BlinkyStitt/smart-compass-v0/designs/carrier/dust-sealing.md

# USB-C inlet and dust protection

The rear cover closes the four old vents and encloses the USB-C inlet
and regulator. The USB-C socket faces down. Fit its tethered cap when
the cable is unplugged. Use the [60 W assembly guide](wall-power-pd60.md)
to finish the opening, check gasket compression and secure the boards.

## Close the other dust paths

| Path | Seal for the prototype |
| --- | --- |
| Rear cover seam | Fit the silicone face seal in the continuous rear-cover groove. Seal the six rear screws separately. |
| Battery door | Seat the hatch gasket on the rear cover and tighten its four screws evenly. Keep the pull ribbon inside the gasket. |
| Front lens and glow ring | Fit the lens cord in the bezel. Fill the two shell shoulder grooves with clear sealant. |
| Buttons and disconnect | Use the supplied O-rings on the three APEM ICP3FAD2 buttons. Fit the C&K 759D02000 boot to the disconnect. Check the underside and fastener paths. |
| Cable passages, strap mounts and fastener pockets | Inspect each opening for a path into the cavity. Close unused cable passages and keep strap hardware in blind features or outside the seal. |
| Printed surfaces | Inspect for cracks, pinholes and layer gaps. Check that the gasket lands are flat and continuous. Verify the finished print as part of the assembly. |

## Fit the rear cover seal

Fit a 1 mm silicone cord loop with a nominal 197.5 mm centreline diameter
(about 620.5 mm circumference). Use a factory joined loop with a smooth
joint. The groove is 1.4 mm wide and 0.8 mm deep. The revised shell has a
continuous bearing face below its strap slots. The cover and shell meet
at the rim and set the nominal seal compression to 20 percent.
Check for full contact with the print seated. Tighten the six M3 screws
evenly in a cross pattern and seal under their washers. Use removable
fastener seals on the four cell cradle mounts. The disconnect guard is
part of the rear cover.
The seven carrier PCB screws use blind pilots.
[Silicone cord source](https://cormanufacturing.com/o-ring-cord-and-custom-extrusions/),
[Parker face seal guidance](https://www.parker.com/content/dam/Parker-com/Literature/O-Ring-Division-Literature/ORD-5700.pdf)

## Fit the battery hatch

Fit a joined 1 mm silicone cord loop in the hatch groove. The nominal
centreline is a rounded rectangle 123.2 × 53.3 mm with 3.6 mm corner radii.
Its length is about 347 mm. The groove is 1.2 mm wide and 0.8 mm deep.
Keep the cradle and its four mounting screws inside the gasket perimeter.
Tap the four blind pilots M3. Fit four M3 × 14 mm screws with 0.5 mm
washers. Check screw depth and tighten evenly until the flange seats.

Disconnect USB and set the disconnect switch to OFF before cell service.
Remove the four screws and lift the hatch straight off. Turn the keeper
only after you can hold the cell. Reseat the keeper before refitting the
hatch. If the hatch rocks or stands proud, check the cell and ribbon
positions before tightening.

## Fit the lens and glow band

Seat a joined 1 mm silicone cord loop in the bezel groove. The centreline
diameter is 183 mm. Check full contact against the acrylic outside the
opening. Fit the six bezel nuts and screws, then close the exposed nut
loading slots with a removable bead of sealant.

Dry fit the glow ring between its two shell shoulders. Apply a small
continuous bead of clear, electronics-compatible neutral-cure silicone
in each shoulder groove. Keep it off the lit wall and acrylic coatings.
Use the sealant maker's cure conditions and check adhesion on PETG scraps.
[DOWSIL 3145 RTV sealant](https://www.dow.com/en-us/pdp.dowsil-3145-rtv-mil-a-46146-adhesive--sealant.01059548z.html)

## Verify the assembled case

Target **IP6X** for the complete assembled case under IEC 60529. Test the
actual print, seals, fasteners, controls, cell door and USB-C panel seal. Test with
the wall cable installed and with the USB-C port capped. Cycle
the door, controls and cable before repeating the dust check. Open the
case in a clean area and inspect inside the electronics and optical cavity
for dust after the chamber test. [IEC 60529 enclosure protection standard](https://webstore.iec.ch/en/publication/2452)

Measure the cell, charger, boost, PD regulator, LED and case temperatures in the closed
vent-free case while the display runs and charges on the wall. Check both
the powered and battery-only configurations. Set the usable brightness
from the measured thermal limits. The complete enclosure seal and the
vent-free thermal limit remain unverified until the physical tests pass.
