BlinkyStitt/smart-compass-v0/(list of files, cad)

Other CAD files:
designs/stacked/exports/FitBatteryContactPFront.3mf
hardware/enclosure/exports/smart-compass.step
hardware/enclosure/sources/sparkle-motion-mechanical/6100.step
designs/stacked/exports/SideDiffuser.3mf
hardware/enclosure/exports/BarrelFrame.3mf
designs/stacked/exports/BatteryKeeper.3mf
hardware/enclosure/exports/FitRear.3mf
designs/stacked/exports/stacked-fibonacci.step
hardware/enclosure/exports/OpticalDeck.3mf
designs/stacked/exports/BlackPillRetainer2.3mf
hardware/enclosure/exports/FitSuspensionRear.3mf
designs/stacked/exports/HarnessSpliceCarrierGND.3mf
hardware/enclosure/exports/FitOptics.3mf
designs/stacked/exports/FitInnerDiffuser-silver.3mf
hardware/enclosure/exports/InnerRing-silver.3mf
designs/stacked/exports/BlackPillRetainer3.3mf
hardware/enclosure/exports/RearPlate.3mf
designs/stacked/exports/FitInnerDiffuser.3mf
hardware/enclosure/exports/FitBarrel.3mf
designs/stacked/exports/FitBatteryContactNFront.3mf
hardware/enclosure/exports/EdgeDiffuser-silver.3mf
designs/stacked/exports/HarnessSpliceCarrierLED_DISTRIBUTION.3mf
hardware/enclosure/exports/FitFibonacciBaffle.3mf
designs/stacked/exports/FitBatteryContactPBack.3mf
hardware/enclosure/exports/FitRingOutside-silver.3mf
designs/stacked/exports/HarnessSpliceCarrierAUX_3V3.3mf
hardware/enclosure/exports/ServiceCover.3mf
designs/stacked/exports/HarnessSpliceCarrierSPI_CLOCK.3mf
hardware/enclosure/exports/VentGuard3.3mf
designs/stacked/exports/StartBackplate.3mf
hardware/enclosure/exports/HaloRing-silver.3mf
designs/stacked/exports/BatteryCradle.3mf
hardware/enclosure/exports/FitRingHalo.3mf
designs/stacked/exports/LatchCarrier.3mf
hardware/enclosure/exports/FitDeck.3mf
designs/stacked/exports/ActionBezel.3mf
hardware/enclosure/exports/NecklaceLink1.3mf
designs/stacked/exports/ActionBackplate.3mf
hardware/enclosure/exports/FitRingInner-silver.3mf
designs/stacked/exports/InnerDiffuser-silver.3mf
hardware/enclosure/exports/FibonacciBaffle.3mf
designs/stacked/exports/StartBezel.3mf
hardware/enclosure/exports/FitSuspensionBracketLeft.3mf
designs/stacked/exports/FitSideDiffuser-silver.3mf
hardware/enclosure/exports/InnerRing.3mf
designs/stacked/exports/RearCover.3mf
hardware/enclosure/exports/NecklaceLink0.3mf
designs/stacked/exports/FitSuspensionLeft.3mf
hardware/enclosure/exports/FitSuspensionBracket.3mf
designs/stacked/exports/SwitchGuard.3mf
hardware/enclosure/exports/VentGuard2.3mf
designs/stacked/exports/HarnessSpliceCarrierB.3mf
hardware/enclosure/exports/FitRingOutside.3mf
designs/stacked/exports/FitHarnessSpliceCarrierSENSE.3mf
hardware/enclosure/exports/EdgeDiffuser.3mf
designs/stacked/exports/FitBatteryDoor.3mf
hardware/enclosure/exports/CircleRimFoot0.3mf
designs/stacked/exports/RadioRetainer0.3mf
hardware/enclosure/exports/CircleRimFoot1.3mf
designs/stacked/exports/InnerDiffuser.3mf
hardware/enclosure/exports/HaloRing.3mf
designs/stacked/exports/ModeBezel.3mf
hardware/enclosure/exports/FitSuspensionFrame.3mf
designs/stacked/exports/EGLStencil.3mf
hardware/enclosure/exports/CircleRimFoot2.3mf
designs/stacked/exports/LatchClamp0.3mf
hardware/enclosure/exports/FitService.3mf
designs/stacked/exports/ElectronicsShell.3mf
hardware/enclosure/exports/FitRingHalo-silver.3mf
designs/stacked/exports/FitHarnessSpliceCarrierGND.3mf
hardware/enclosure/exports/VentGuard1.3mf
designs/stacked/exports/BoardEdgeClip0.3mf
hardware/enclosure/exports/FitController.3mf
designs/stacked/exports/CapacitorCover.3mf
hardware/enclosure/exports/VentGuard0.3mf
designs/stacked/exports/HarnessSpliceCarrierSPI_MISO.3mf
hardware/enclosure/exports/FitRingInner.3mf
designs/stacked/exports/HarnessSpliceCarrierFIB_5V.3mf
hardware/enclosure/exports/OpticalDeckQ2.stl
designs/stacked/exports/BlackPillCarrier.3mf
hardware/enclosure/exports/OpticalDeckQ4.stl
designs/stacked/exports/FitStartBezel.3mf
hardware/enclosure/exports/BarrelFrameQ3.stl
designs/stacked/exports/RadioCarrier.3mf
hardware/enclosure/exports/RearPlateQ3.stl
designs/stacked/exports/SideDiffuser-silver.3mf
hardware/enclosure/exports/SeamStraps-03.stl
designs/stacked/exports/BatteryContactNFront.3mf
hardware/enclosure/exports/CircleBezel.stl
designs/stacked/exports/RadioRetainer2.3mf
hardware/enclosure/exports/OpticalDeckQ1.stl
designs/stacked/exports/ModeBackplate.3mf
hardware/enclosure/exports/RearPlateQ1.stl
designs/stacked/exports/FitBatteryCradle.3mf
hardware/enclosure/exports/CellBaffle.stl
designs/stacked/exports/HarnessSpliceCarrierSPI_MOSI.3mf
hardware/enclosure/exports/SeamStraps-12.stl
designs/stacked/exports/HarnessSpliceCarrierSENSE.3mf
hardware/enclosure/exports/SeamStraps-04.stl
designs/stacked/exports/LatchClamp2.3mf
hardware/enclosure/exports/RearPlateQ2.stl
designs/stacked/exports/FitSideDiffuser.3mf
hardware/enclosure/exports/OpticalDeckQ3.stl
designs/stacked/exports/HarnessSpliceCarrierBOOST_OUT.3mf
hardware/enclosure/exports/SeamStraps-11.stl
designs/stacked/exports/BoardEdgeClip2.3mf
hardware/enclosure/exports/BarrelFrameQ1.stl
designs/stacked/exports/FitLatchCarrier.3mf
hardware/enclosure/exports/SeamStraps-08.stl
designs/stacked/exports/BatteryDoor.3mf
hardware/enclosure/exports/SeamStraps-10.stl
designs/stacked/exports/BatteryContactPBack.3mf
hardware/enclosure/exports/RearPlateQ4.stl
designs/stacked/exports/BoardEdgeClip1.3mf
hardware/enclosure/exports/BarrelFrameQ2.stl
designs/stacked/exports/LatchClamp1.3mf
hardware/enclosure/exports/SeamStraps-02.stl
designs/stacked/exports/BlackPillRetainer1.3mf
hardware/enclosure/exports/SeamStraps-05.stl
designs/stacked/exports/FitSuspensionRight.3mf
hardware/enclosure/exports/BarrelFrameQ4.stl
designs/stacked/exports/BlackPillRetainer0.3mf
hardware/enclosure/exports/SeamStraps-06.stl
designs/stacked/exports/BatteryContactNBack.3mf
hardware/enclosure/exports/SeamStraps-09.stl
designs/stacked/exports/BatteryContactPSpacer1.3mf
hardware/enclosure/exports/BoardMounts-13.stl
designs/stacked/exports/BlackPillDrainBridge.3mf
hardware/enclosure/exports/BoardMounts-07.stl
designs/stacked/exports/StartCompression0.3mf
hardware/enclosure/exports/SeamStraps-07.stl
designs/stacked/exports/BatteryContactNSpacer1.3mf
hardware/enclosure/exports/HatchStandoff1.stl
designs/stacked/exports/BoostInputRelief.3mf
hardware/enclosure/exports/BoardMounts-06.stl
designs/stacked/exports/FitBoardEdgeSeat.3mf
hardware/enclosure/exports/BoardMounts-12.stl
designs/stacked/exports/ModeCompression1.3mf
hardware/enclosure/exports/BoardMounts-14.stl
designs/stacked/exports/ModeCompression0.3mf
hardware/enclosure/exports/BoardMounts-09.stl
designs/stacked/exports/BatteryHingeSpacer0.3mf
hardware/enclosure/exports/BoardMounts-10.stl
designs/stacked/exports/RadioRetainer1.3mf
hardware/enclosure/exports/BoardMounts-03.stl
designs/stacked/exports/FitBatteryContactNBack.3mf
hardware/enclosure/exports/SeamStraps-01.stl
designs/stacked/exports/FitBoardEdgeClip0.3mf
hardware/enclosure/exports/BoardMounts-05.stl
designs/stacked/exports/FitBatteryKeeper.3mf
designs/stacked/exports/ActionBackplate.stl
designs/stacked/exports/ActionBezel.stl
designs/stacked/exports/ActionCompression0.3mf
designs/stacked/exports/ActionCompression1.3mf
designs/stacked/exports/ActionCompression1.stl
designs/stacked/exports/BatteryContactNSpacer0.3mf
designs/stacked/exports/BatteryContactNSpacer0.stl
designs/stacked/exports/BatteryContactNSpacer1.stl
designs/stacked/exports/BatteryContactPBack.stl
designs/stacked/exports/BatteryContactPSpacer0.3mf
designs/stacked/exports/BatteryContactPSpacer0.stl
designs/stacked/exports/BatteryDoor.stl
designs/stacked/exports/BatteryHingeSpacer1.3mf
designs/stacked/exports/BatteryHingeSpacer1.stl
designs/stacked/exports/BlackPillCarrier.stl
designs/stacked/exports/BlackPillDrainBridge.stl
designs/stacked/exports/BlackPillRetainer1.stl
designs/stacked/exports/BlackPillRetainer2.stl
designs/stacked/exports/BlackPillSenseBridge.3mf
designs/stacked/exports/BranchFuseCarrier.3mf
designs/stacked/exports/BranchFuseCarrier.stl
designs/stacked/exports/CapacitorCover.stl
designs/stacked/exports/EGLStencil.stl
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
