BlinkyStitt/smart-compass-v0/designs/carrier/assembly.md

# Rev A carrier assembly

Use the [routed KiCad board](carrier-a.kicad_pcb) with the 200 mm narrow
enclosure. The board is 1.2 mm thick with four 35 µm copper layers. Keep the
seven rear-cover mounts. Tap their blind 1.6 mm pilots M2 with a depth
stop. Fit seven M2 × 4 mm screws with insulating washers. Check that the
screws hold without bottoming out. The five stock boards plug into the
low-profile sockets from the fit model. Secure the boards with the common
retainer. Pull a connector by its housing and support the carrier near it.

Have the PCB assembler install the small surface-mount parts. Fit the socket
strips, harness headers and axial fuses after reflow. Use a jig to keep the
matching male pins straight when soldering them to the modules. The PowerBoost
uses its stock terminal-block and LBO header holes. Leave R20 and the factory
red LED in place. Use the stock Sparkle Motion barrel jack and screw clamps.
The LED board inputs, switch and cell contacts still need bench wiring. Make
these as subassemblies so final assembly is screw and plug work.

## Fit the carrier retainer

Fit the seven boards and their plugs on the bench. Fit soft insulating
silicone pads to the retainer toes. Use 1 mm stock for the 0.8 mm installed
gap. The five round toes bear around stock mounting holes. The other
three toes bear on the outer PCB edges of the radio, BlackPill and latch.
Keep pads on those bearing faces and clear of headers and components.
Check that each pad touches its PCB when all five feet sit on their stops.
Check for PCB flex before tightening.

Ream the five frame bores to 2.8 mm if needed. Tap the rear cover's 2.05 mm
blind pilots M2.5 × 0.45. Use five M2.5 × 25 mm button-head screws with
heads no wider than 4.5 mm and no taller than 1.6 mm. Tighten by hand until
the frame feet seat. Move the local service folds clear before lifting
the retainer during service. [Example M2.5 × 25 mm hardware](https://www.aspenfasteners.com/m2-5-0-45-x-25mm-iso-7380-1-metric-button-head-hex-socket-cap-screws-class-10-9-steel-plain/)

## Install the panel controls

Use three black, flat [APEM ICP3FAD2](https://www.apem.com/en-us/panel-switches/pushbutton-switches/ic/icp3fad2)
normally open buttons with factory flying leads. Fit the supplied O-ring
under each flange. The 2 mm panel lands have a 13.60 mm opening with flats
12.90 mm apart. Hold the button against the flats while tightening the
supplied nut. Check the seal seats fully and the button returns freely.
APEM specifies a maximum nut torque of 1.5 N·m. Use only the torque needed
to seat the seal against the printed land.

Use the factory 20 AWG leads to make a bench harness. Join them to the
26 AWG PH leads using insulated splices rated for the two wire sizes.
Leave 20 mm of service slack. Fit the C&K 759D02000 sealing boot on the
7201SYZQE disconnect in place of its external nut. Check that the boot moves freely
in both positions. Check both switch poles with a continuity meter. [C&K switch and boot drawing](https://www.ckswitches.com/media/1394/7000toggle.pdf)

## Fit the battery contacts

Print the cradle and the two `BatteryContact*Front` clamps. Clear the
support material from the wire passages, contact seats, and screw holes.
Finish the fixed seats and clamp bores to 2.75 ± 0.05 mm. Feed the bare
wire through its conduit before soldering the contact outside the print.
Let it cool. Pull the wire through until the contact flange seats against
the integral back face.
Fit the front clamp over the plunger. Keep the original M2 fasteners
and the 0.25 mm insulating washers at the compression bosses. Fit the negative clamp with its insulating stop at the
negative end. Support the leads during tightening.

Check that each contact is captive, its plunger moves freely, and the
positive contact stays insulated from the mounting hardware.
Use the keyed contact dimensions below to set the Rev A clamps.
[Spring-contact reference drawing](../../hardware/enclosure/battery-access.md)

## Plugs

Pin order is the PCB pad order starting at pin 1. Read pad numbers in KiCad or
use the square pad for the JST headers. Label both ends of each lead before
installation. Use the [carrier parts and pad map](routed-components.json) for
part locations. Use the [stock module source records](../../hardware/enclosure/electrical-design.md)
for the module pins.

| Carrier | Header | Connections in pad order |
| --- | --- | --- |
| J1 | JST B4P-VH | Charger BAT, ground, charger SYS, charger TS sense |
| J2 | JST B3P-VH | Fused cell positive through S1 pole A, cell negative, holder thermistor |
| J3 | JST B5P-VH | Pololu VIN, VOUT, GND, A, OFF |
| J4 | JST B6P-VH | PowerBoost X2.2, X2.1, X1.2, X1.1, JP1.4 LBO, empty |
| J5 | JST B2B-XH-A | S1 pole B RUN contact, S1 pole B common |
| J6 | JST B2P-VH | Sparkle Motion 2.1 mm barrel plug center, sleeve |
| J7 | JST B5B-XH-A | Sparkle JP1.9, JP1.7, JP1.8, JP1.5, JP1.2 |
| J8 | JST B3B-XH-A | Fibonacci 5V, GND, DIN |
| J9 | JST B3B-XH-A | Inner ring 5V, GND, DIN |
| J10 | JST B3B-XH-A | Side ring A 5V, GND, DIN |
| J11 | JST B3B-XH-A | Side ring B 5V, GND, DIN |
| J12 | JST B6B-PH-K | Start pair, Mode pair, Action pair |

J8 through J11 have the same power, ground and data order. Labels identify the
four outputs. Keep the 1000 µF bulk capacitor at the Fibonacci end of J8. R8
drains this branch while J8 is seated. Keep all other USB ports for service and
isolate them from live wall or battery power.

Use precrimped 18 AWG for the cell power and charger SYS paths, 22 AWG for the
barrel feed and LED power, and 26 AWG for controls and LED data. Match the
terminal to each wire gauge. Where the VH contact range ends at 22 AWG, join
the short 22 AWG pigtail to a thinner control or thermistor lead in the
subassembly. Use one conductor per clamp on Sparkle Motion.

Keep the contact-adjacent 4 A fuse in the positive cell lead. Connect the fused
positive lead to S1 terminal 1 and J2.1 to terminal 2. Connect J5.1 to terminal
4 and J5.2 to terminal 5. Insulate unused S1 terminals 3 and 6. Check the
delivered switch with a continuity meter in both positions. The ground return
and thermistor stay in the holder harness. The battery positive contact is
isolated in OFF. Unplug wall USB before opening the case or changing the cell.

## Make the first harness against the actual case

- Leave 25 mm of slack at the cell, charger, switch, and LED clamp harness.
- Leave 20 mm at the barrel, boost, latch, and button harnesses.
- Leave 40 mm in each of the four front LED cables so the cover can open
  about 30 mm and leave 10 mm for access to the plugs.
- Route the power and return leads together. Form gentle U-bends in the
  available spaces. Use a removable soft tie to hold each fold. Keep bends out
  of the battery door path, cover rim, and fastener seats.

Measure the bent route between the actual lead exits and add the slack and
termination allowance before cutting. The model checks room for the mated
housings and the existing fold reservations. The charger harness needs its
own fitted fold and lead-exit check. Test finger access and the completed wires on the
first assembly. Check module retention and antenna behavior with the PCB in
place. Weigh the assembled prototype to capture the cost of the extra plugs
and charger.

## Check the keyed positive contact

Use both revised front clamps from the Rev A print package. The circular
guard on `BatteryContactPFront` faces the cell. Clear its opening of print
material and keep the insulating bearing face flat.
With both power sources disconnected, check that the unloaded positive pin is
0.42–0.56 mm behind that face. Set the unloaded tip gap to 74.12–74.20 mm and the
negative stop compression to 1.82–1.90 mm.

The keyed holder accepts a protected 21700 cell 74.3–75.3 mm long and
21.5–22.1 mm in diameter. Check the actual XTAR cell. Its positive button
must be 5–9 mm in diameter, 1.0–1.6 mm high and within 1 mm of the opening axis
when seated. The negative end must have no more than 0.27 mm of central
protrusion toward the pin when its bearing surface is against the clamp.
Use electrically isolated dummy gauges to check contact in the correct
orientation and no contact during reversed insertion or with the keeper closed.
Confirm that pushing against the negative stop releases the button
before withdrawing the dummy. A cell outside these limits needs a fit
review. [XTAR product sheet](https://www.xtar.cc/download/21700-6000mah-data-sheet?wpdmdl=10996)

## Verify the carrier

Open the board in KiCad 10. Run the DRC with the ground plane refilled.

```sh
kicad-cli pcb drc --refill-zones --exit-code-violations \
  designs/carrier/carrier-a.kicad_pcb
```

The board contains the editable copper. `pcb_placement.py` still makes the
stock socket and outline gauge. `route_board.py` adds the power and harness
connections and exports a Specctra placement from that gauge. Use the stock
footprint libraries from KiCad 10. Review routing after any changes to the
placement or connector map.

For the mechanical check, set `COMPASS_CARRIER_SOURCE` to the absolute
path to `designs/carrier` and set `COMPASS_CARRIER_OUTPUT` to a writable
directory. Run `RunRoutedFit.FCMacro` in FreeCAD. It records the mated plugs,
the internal USB-C hardware, charger envelope, hatch and retainer fit and cell service in
`routed-fit.json`. It exports `usb-c-rear-cover.step` and the nine revised
print solids as STLs. Make the complete print package with the
[Rev A build instructions](README.md#make-the-rev-a-print-package).

Use the [wall power design](wall-power-pd60.md) and [dust sealing plan](dust-sealing.md)
before connecting the charger or a cell. First power up the carrier through
J1 SYS and GND on a current-limited 3.6 V bench supply with the battery and
charger disconnected. Check SYS at the latch plug and check for shorts. Install the latch and boost next.
Measure the 5 V rail before installing the other modules and LED loads.
