BlinkyStitt/smart-compass-v0/hardware/enclosure/service-guide.html

# Smart Compass: $material_label print service handoff

Package $package_id · All dimensions are millimetres.

Print samples first. Hold the full order.

Quote both stages. Print $samples disposable samples first. Print the $products full assembly parts only after the customer confirms sample acceptance and releases that stage.

CAD and slicing checks passed. Physical print, fit, strength and optical acceptance remain pending.

## 1. Confirm that you can make this job

- Use a printer with at least a 300 × 300 mm bed. Keep every complete part, brim and skirt inside the actual usable bed. Keep all circles whole. Keep the supplied scale and bed orientation.
- Use opaque black PETG for the frame, deck, rear, brackets, original EGL centre stencil, spacers, guards and cover. Use $material_name for the three light rings and their arc samples. Identify your proposed opaque black PETG brand and grade before printing. Check that the production-wall samples block visible LED light at the permitted power limit. Reject light transmission through the black parts. Keep this filament option separate from the other material version.
- Use a 0.4 mm nozzle. $nozzle_instructions
- Use a $brim mm brim, with $brim_gap mm brim separation, and no supports. Keep elephant-foot compensation at $foot mm.
- Print the samples on the production machine with the production filament and settings. Agree to inspect dimensions and functional fits with the actual mating hardware.

$evidence Both versions use the same strong outside wall. Each material needs its own sample acceptance.

## 2. Which files should you use?

Folder / file | Purpose
01-SAMPLES-PRINT-FIRST | Start here. One of each sample. Both bracket arrangements are included.
02-FULL-PARTS-HOLD | One complete $products-part set. Hold until the customer releases it.
03-STL-ALTERNATIVES | The same parts as plain STL geometry. Use these only if your slicer cannot use the 3MF files. Apply the table settings and import in millimetres. These are not additional pieces to print.
04-REFERENCE-DO-NOT-PRINT | Assembly views, a section drawing and the complete assembly STEP. Use them to understand the fit. The STEP includes nonprinted items and is not one print job.
ORDER.csv | The two-stage quantity, material and settings list. Each listed 3MF contains one part.
CHECKSUMS.sha256 | File checksums for shipment integrity.

3MF files are slicer projects, not printer programs. They contain geometry, orientation and reference print settings. They deliberately omit heater setpoints and machine start/end programs. Select your actual machine and filament presets, then retain the specified geometry and process settings. Check the resulting paths before printing. Do not run G-code with zero heater setpoints.

## 3. Sample order — print these first

One of each file below. These samples are disposable and do not enter the final assembly.

File | Use | Qty | Material | Layer / walls | Infill | Path / first layer | Top / bottom layers

$sample_rows

## 4. Full order — hold for sample acceptance

Print the listed quantities below for one complete $products-part printed set. The similarly named spacers and guards are distinct positioned parts; keep their file identities.

File | Part | Qty | Material | Layer / walls | Infill | Path / first layer | Top / bottom layers

$product_rows

### Orientation and path checks

- Keep the optical deck floor down, barrel deck-joint face down, rear skin down, vent guards roof down and necklace brackets flat. Preserve the supplied orientation for the other parts and all fit samples. The projects are centred on the 300 mm reference bed. Centre each part on your actual usable bed without changing its scale; check the whole brim and skirt too.
- Print each light ring upright on its circular bottom edge. Keep the cavity ring walls at $cavity_wall mm and the outside wall at $outside_wall mm. Their 0% infill setting uses continuous perimeter paths to fill the walls.
- Inspect $cavity_paths nominal $cavity_path mm paths in each cavity ring and $outside_paths nominal $outside_path mm paths in the outside ring. The outside first-layer paths are nominally $outside_first_path mm. Check every layer for continuous complete walls, with no missing path, gap fill or internal lattice.
- Print the original EGL centre stencil flat, 2 mm thick, with the supplied 0.1 mm layers, 0.4 mm paths and 100% rectilinear infill. Inspect all thin walls. Fit the complete stencil sample on the actual board, with its three separate spacers and the black LED acrylic front. Keep the source open edge cells.
- The optical deck uses $deck_layer mm layers with $deck_top solid top layers and $deck_bottom solid bottom layers. The first layer stays at $first_layer mm. Retain the collar stops, sheet lands and existing solid skins.

## 5. Sample acceptance — agree with the customer

The customer must supply the actual boards, strips, finished acrylic and fasteners for functional checks. If you cannot do these checks, return the labelled samples for customer testing. Report the machine, filament product/lot, nozzle, settings, measured dimensions and any defects.

- Use actual M3 and M2 screws, plain nuts and washers. Check free screw passage, complete nut insertion and thread engagement, captive-nut pockets, controller mounting and screwdriver access. Keep the rear skin closed.
- Test both bracket arrangements and mating frame/rear samples. Check that the rear can be removed independently.
- Test the front clamp with the actual finished acrylic, 9 mm OD metal washers, and 9 mm OD × 6.4 mm ID soft washers cut from 0.020 inch Stockwell SG-30 GP silicone. Target 60% of measured free washer thickness. The metal washer must bear on the collar while the soft washer retains the sheet. Record the usable tightening limit.
- Test all three ring curvatures and seats. Retain each ring at maximum permitted lift. Require 0.2–0.8 mm measured clearance below the front sheet and at least 0.5 mm actual LED clearance. Keep the $mirror_separation mm mirror separation and at least 18 mm radial cavity width.
- Inspect the $outside_wall mm outside arc for voids, cracks and layer separation. Repeat installation and removal. Whole-ring handling still requires a full-size test.
- Fit the three opaque light shields, actual strips and front-sheet sample. Reject exposed LED edges or light leaking above the rings. Check shield adhesion, sag, sheet clearance and removal with the ring. The shields use 0.06 mm tesa 7160 black PET tape; they are separate cut parts.
- $optical_acceptance Use the customer's permitted LED power limit. The rendered appearance is an unmeasured illustration.

If a sample fails, stop the full order, correct the cause and repeat the affected test. Do not substitute material or relax an acceptance requirement without a new customer decision.

## 6. Full-size inspection and packing

- Inspect cooled parts after brim removal. Reject cracks, incomplete walls, lifted edges, permanent distortion and layer separation. Do not use bolts to flatten a part.
- Dry-assemble the complete set on a flat reference. Require joint gaps no greater than 0.3 mm, free screw passage, full nut engagement, retained rings, the specified optical gaps, and independent rear removal.
- Label every part with its filename on removable packaging. Protect ring walls, collar stops, bearing faces and nut mouths. Report finished part masses after brim removal.
- After assembly, the customer must weigh the complete pendant and necklace and repeat the suspension, sustained-load, cyclic-load and service tests. Print acceptance does not establish thermal or dust acceptance.

## 7. What is outside this print order?

The flat black LED acrylic front, rear mirror, coatings, light shields, soft washers, hardware, electronics, wiring and webbing are separate supplied or fabricated items. They are not plastic print jobs. The assembly references show some of these items so you can see the mating interfaces.

## Assembly references

These show the common geometry. Image colours show the baseline glow assembly; use the material specified in this order for printing.

Complete assembly STEP · Section drawing

### Assembled

Current assembled pendant

### Exploded reference

Separated assembly parts for fit reference
