BlinkyStitt/smart-compass-v0/(list of files, drawings)

Other design files:
smart-compass-v2.fzz
smart-compass.fzz
