BlinkyStitt/smart-compass-v0/designs/carrier/wall-power/led-power.kicad_pcb

## KiCad design designs/carrier/wall-power/led-power.kicad_pcb (2026-11-13)

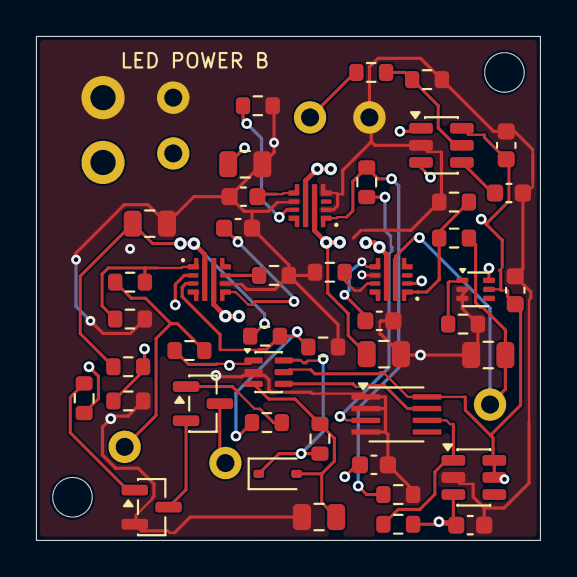
[picture p1: board led-power.kicad_pcb from above]

Board: 4 copper layers, 28.0 x 28.0 mm, 56 parts (0 on the bottom side), 30 nets.

Parts:
C1, C4, C6: 1uF 16V X7R; C_0805_2012Metric
C2, C5, C7: 10nF 16V X7R; C_0603_1608Metric
C3: 10uF 16V X7R; C_0805_2012Metric
C8, C9, C10, C13: 100nF 16V X7R; C_0603_1608Metric
C11: 470pF C0G; C_0603_1608Metric
C12: 4.7uF 25V X7R; C_0805_2012Metric
D1: BAS416; D_SOD-323
H1, H2: M2; MountingHole_2.2mm_M2
Q1, Q2: MMBT3904LT1G; SOT-23
R1, R12: 15k 1%; R_0603_1608Metric
R2, R4, R10, R13, R17: 10k 1%; R_0603_1608Metric
R3: 35.7k 1%; R_0603_1608Metric
R5: 1.27k 1%; R_0603_1608Metric
R6, R15, R18: 10k; R_0603_1608Metric
R7: 56k; R_0603_1608Metric
R8, R21: 47k; R_0603_1608Metric
R9: 27.4k 1%; R_0603_1608Metric
R11: 3.32k 1%; R_0603_1608Metric
R14: 1.30k 1%; R_0603_1608Metric
R16: 82.5k 1%; R_0603_1608Metric
R19: 100k 1%; R_0603_1608Metric
R20: 18.7k 1%; R_0603_1608Metric
U1, U2: TPS259470ARPWR; Texas_RPW_VQFN-10_2x2mm
U3: TPS259474LRPWR; Texas_RPW_VQFN-10_2x2mm
U4: SN74LVC1G74DCTR; SSOP-8_2.95x2.8mm_P0.65mm
U5: TPS3808G33DBVR; SOT-23-6
U6: TPS3808G01DBVR; SOT-23-6
U7: SN74LVC2G14DCKR; SOT-363_SC-70-6
U8: TMP390A2DRLR; Texas_DRL0006A_SOT-563
W1: WALL 5V; Lead_18AWG
W2: WALL GND; Lead_18AWG
W3: CHARGE 5V; Lead_22AWG
W4: CHARGE GND; Lead_22AWG
W5: BAT 5V; Lead_22AWG
W6: LED 5V; Lead_22AWG
W7: LED GND; Lead_22AWG
W8: LOGIC 5V; Lead_22AWG
W9: WALL_N; Lead_22AWG

Connections:
/ALLOW_LED: R12.1, R21.1, U4.3
/BAT_5V: C4.1, R9.1, U2.5, W5.1
/EN_BAT: R9.2, R10.1, U2.1
/EN_LED: R12.2, R13.1, U3.1
/FAULT_FILTER: C12.1, D1.2, R19.2, U7.3
/FAULT_HIGH: D1.1, R19.1, U7.6
/FAULT_N: R18.1, U6.1, U7.1, U8.6
/GND: C1.2, C2.2, C3.2, C4.2, C5.2, C6.2, C7.2, C8.2, C9.2, C10.2, C11.2, C12.2, C13.2, Q2.2, R2.2, R4.2, R5.2, R7.2, R10.2, R11.2, R13.2, R14.2, R17.2, R20.2, U1.8, U2.8, U3.2, U3.4, U3.8, U4.1, U4.2, U4.4, U5.2, U6.2, U7.2, U8.2, U8.3, W2.1, W4.1, W7.1
/LED_5V: C3.1, R16.1, U3.6, W6.1
/LED_SENSE: R16.2, R17.1, U6.5
/LED_SOURCE: C6.1, U1.6, U2.6, U3.5
/LIMIT_BAT: R11.1, U2.9
/LIMIT_LED: R14.1, U3.9
/LIMIT_WALL: R5.1, U1.9
/LOGIC_5V: C8.1, C9.1, C10.1, C13.1, R1.1, R15.2, R18.2, U4.8, U5.3, U5.5, U5.6, U6.3, U6.6, U7.5, U8.5, W8.1
/MODE_BASE: Q1.1, R8.2
/MODE_GND: Q1.2, Q2.3
/OK_BASE: Q2.1, R21.2
/OV_WALL: R3.2, R4.1, U1.2
/RESET_N: R15.1, U4.6, U5.1
/RUN: R1.2, R2.1, U1.1
/SLEW_BAT: C5.1, U2.7
/SLEW_LED: C7.1, U3.7
/SLEW_WALL: C2.1, U1.7
/TEMP_SET: R20.1, U8.1
/TRIP_N: U4.7, U7.4
/UV_DELAY: C11.1, U6.4
/WALL_5V: C1.1, R3.1, R6.1, U1.5, W1.1, W3.1
/WALL_ACTIVE: R6.2, R7.1, R8.1, U1.3, U2.2
/WALL_N: Q1.3, W9.1
