BlinkyStitt/smart-compass-v0/hardware/enclosure/cad.py

"""Rebuild all CAD outputs, or check their working-tree/staged freshness."""

import argparse
from contextlib import contextmanager
import fcntl
import hashlib
import json
import os
from pathlib import Path, PurePosixPath
import shutil
import subprocess
import sys
import tempfile

ROOT = Path(__file__).resolve().parents[2]
CAD = 'hardware/enclosure'
MASTER = CAD + '/smart-compass.FCStd'
EXPORTS = CAD + '/exports'
MANIFEST = CAD + '/exports-manifest.json'
INPUTS = (
    'justfile', 'validation.just', 'design-v2.md',
    *(CAD + '/' + name for name in (
        'cad.py', 'build.py', 'check.py', 'geometry.py', 'baffle.py',
        'antenna.py', 'antenna_native.py', 'test_antenna.py', 'antenna-placement.md', 'README.md',
        'native_publication.py', 'test_native_publication.py',
        'vendor/evilgeniuslabs-fibonacci256/Fibonacci256voronoi.stl',
        'vendor/evilgeniuslabs-fibonacci256/LICENSE.txt',
        'vendor/evilgeniuslabs-fibonacci256/README.txt',
        'vendor/evilgeniuslabs-fibonacci256/SOURCE.md',
        'Run.FCMacro', 'Build.FCMacro', 'Check.FCMacro',
        'parameters.json', 'acrylic-optics.json', 'fibonacci256-layout.json', 'smart-compass.FCStd',
        'test_geometry.py', 'test_cad.py', 'service_package.py', 'service-guide.html', 'test_service_package.py', 'demo_export.py', 'slicing.py', 'print-spec.json', 'hardware_spec.py', 'inventory.py', 'component-inventory.json', 'test_manufacturing.py',
    )),
    *('demo/' + name for name in (
        'project.godot', 'main.tscn', 'main.gd', 'patterns.gd', 'pattern_checks.gd', 'check_patterns.gd', 'capture_view.gd', 'playa.gd', 'mannequin.gd', 'assets/playa-night.png', 'optics.gdshader',
        'centre_diffusion.gdshaderinc', 'centre_diagnostic.gdshader', 'sleeve.gdshader', 'cell.gdshader', 'package.gdshader', 'centre.gdshader', 'cavity_trace.gdshaderinc',
        'diagnostic.gdshader', 'diffuser_diagnostic.gdshader', 'ring_diffusion.gdshaderinc', 'glow.gd', 'glow_diagnostic.gdshader', 'run.py', 'reference.py', 'media.py', 'test_demo.py', 'test_media.py',
    )),
)
FIXED_EXPORTS = frozenset('''
EdgeDiffuser-silver.3mf
FitBarrel.stl
FitController.stl
FitDeck.stl
FitFibonacciBaffle.stl
FitOptics.stl
FitRear.stl
FitRingHalo-silver.3mf
FitRingHalo.stl
FitRingInner-silver.3mf
FitRingInner.stl
FitRingOutside-silver.3mf
FitRingOutside.stl
FitService.stl
FitSuspensionBracket.stl
FitSuspensionBracketLeft.stl
FitSuspensionFrame.stl
FitSuspensionRear.stl
HaloRing-silver.3mf
InnerRing-silver.3mf
amulet-silver.glb
amulet.glb
assembly-section.svg
antenna-placement.svg
assembly.png
circle-alignment-overlay.svg
diffusers.png
edge.png
electronics.png
exploded.png
fit-sheet.svg
front-coating.svg
front-sheet.svg
front.png
halo-light-shield.svg
infinity-rainbow-silver.gif
infinity-rainbow-silver.mp4
infinity-rainbow.gif
infinity-rainbow.mp4
infinity-rainbow-dark-sectors.mp4
infinity-rainbow-dark-spirals.mp4
infinity-rainbow-dark-diagonals.mp4
inner-light-shield.svg
night-mannequin.png
outer-light-shield.svg
parts.json
rear-mirror.svg
rear.png
scene.json
smart-compass-glow-print-service.zip
smart-compass-silver-print-service.zip
smart-compass.step
soft-front-washer.svg
'''.split())
GENERATED_SUFFIXES = {'.stl', '.step', '.svg', '.png', '.gif', '.mp4', '.json', '.glb', '.3mf', '.zip'}
RETIRED_EXPORTS = frozenset(EXPORTS + '/' + name for name in '''
amulet-demo.mp4
demo-edge-indoor.png
demo-edge-night.png
demo-edge-overcast.png
demo-edge-sun.png
demo-front-indoor.png
demo-front-night.png
demo-front-overcast.png
demo-front-sun.png
demo-rear-indoor.png
demo-rear-night.png
demo-rear-overcast.png
demo-rear-sun.png
demo-steep-indoor.png
demo-steep-night.png
demo-steep-overcast.png
demo-steep-sun.png
edge-diffuser.svg
exploded-poster.png
exploded.gif
exploded.mp4
glow-afterglow-poster.png
glow-afterglow.gif
glow-afterglow.mp4
halo-ring-diffuser.svg
infinity-ocean.gif
infinity-sunset.gif
inner-ring-diffuser.svg
lighting-demo.mp4
smart-compass-print-service.zip
turntable-poster.png
turntable.gif
wood-fibonacci-mask.svg
'''.split())

class CadError(Exception):
    pass


def digest(data):
    return hashlib.sha256(data).hexdigest()


class Snapshot:
    def __init__(self, root, staged=False):
        self.root = Path(root)
        self.staged = staged

    def read(self, path):
        if self.staged:
            result = subprocess.run(['git', 'cat-file', '--filters', ':' + path], cwd=self.root,
                                    stdout=subprocess.PIPE, stderr=subprocess.PIPE)
            if result.returncode:
                raise CadError('Cannot read staged file: ' + path)
            return result.stdout
        try:
            return (self.root / path).read_bytes()
        except OSError as exc:
            raise CadError('Cannot read ' + path + ': ' + str(exc)) from exc

    def export_paths(self):
        if self.staged:
            output = subprocess.check_output(
                ['git', 'ls-files', '-z', '--', EXPORTS + '/'], cwd=self.root)
            paths = [p.decode() for p in output.split(b'\0') if p]
        else:
            paths = [p.relative_to(self.root).as_posix()
                     for p in (self.root / EXPORTS).rglob('*') if p.is_file()]
        return {p for p in paths if PurePosixPath(p).suffix.lower() in GENERATED_SUFFIXES}


def load_json(snapshot, path):
    try:
        return json.loads(snapshot.read(path))
    except (ValueError, UnicodeError) as exc:
        raise CadError('Invalid JSON: ' + path) from exc


def required_exports(snapshot):
    parts = load_json(snapshot, EXPORTS + '/parts.json')
    names = parts.get('stl_files') if isinstance(parts, dict) else None
    if not isinstance(names, list) or not names:
        raise CadError('parts.json must list the generated STL files')
    for name in names:
        if (not isinstance(name, str) or not name.endswith('.stl')
                or PurePosixPath(name).name != name or '\\' in name):
            raise CadError('Unsafe STL filename in parts.json: ' + repr(name))
    if len(set(names)) != len(names):
        raise CadError('Duplicate STL filename in parts.json')
    meshes = FIXED_EXPORTS.union(names)
    projects = {str(PurePosixPath(name).with_suffix('.3mf')) for name in meshes if name.endswith('.stl')}
    return {EXPORTS + '/' + name for name in meshes.union(projects)}


def hashes(snapshot, paths):
    result = {}
    for path in sorted(paths):
        data = snapshot.read(path)
        if not data:
            raise CadError('Empty CAD file: ' + path)
        result[path] = digest(data)
    return result


def validate_inventory(snapshot):
    expected = required_exports(snapshot)
    actual = snapshot.export_paths()
    if expected != actual:
        details = (['Missing export: ' + p for p in sorted(expected - actual)]
                   + ['Unexpected export: ' + p for p in sorted(actual - expected)])
        raise CadError('\n'.join(details))
    return expected


def check_freshness(snapshot, *, publishing=False):
    import native_publication
    if not publishing and native_publication.pending(snapshot.root / '.build/wide-publication'):
        raise CadError('Interrupted native publication; run just cad to restore the prior complete release')
    manifest = load_json(snapshot, MANIFEST)
    if not isinstance(manifest, dict) or manifest.get('format_version') != 1:
        raise CadError('Unsupported CAD freshness manifest')
    exports = validate_inventory(snapshot)
    changed = []
    for group, paths in (('inputs', set(INPUTS)), ('exports', exports)):
        recorded = manifest.get(group)
        if not isinstance(recorded, dict) or set(recorded) != paths:
            raise CadError('CAD manifest has an incomplete ' + group + ' inventory')
        current = hashes(snapshot, paths)
        changed.extend(path for path in current if recorded[path] != current[path])
    if changed:
        raise CadError('CAD files differ from the last complete build:\n'
                       + '\n'.join(changed))


@contextmanager
def build_lock(root):
    # The directory inode is stable across aliases and different TMPDIR values.
    # Closing the descriptor releases the lock without leaving a lock file.
    descriptor = os.open(root.resolve(), os.O_RDONLY)
    try:
        try:
            fcntl.flock(descriptor, fcntl.LOCK_EX | fcntl.LOCK_NB)
        except BlockingIOError as exc:
            raise CadError('A CAD rebuild is already running for this checkout') from exc
        yield
    finally:
        os.close(descriptor)


def atomic_write(path, data):
    path.parent.mkdir(parents=True, exist_ok=True)
    fd, temporary = tempfile.mkstemp(prefix='.' + path.name + '-', dir=path.parent)
    try:
        with os.fdopen(fd, 'wb') as stream:
            stream.write(data)
        os.replace(temporary, path)
    finally:
        Path(temporary).unlink(missing_ok=True)


def ensure_unchanged(root, original):
    current = hashes(Snapshot(root), INPUTS)
    changed = [path for path in current if original[path] != current[path]]
    if changed:
        raise CadError('Source changed during the build; no results were copied back:\n'
                       + '\n'.join(changed))


def native_stage(freecad, directory, stage):
    result = directory.parent / (stage + '-complete.json')
    env = dict(os.environ, SC_CAD_DIR=str(directory), SC_CAD_STAGE=stage,
               SC_CAD_RESULT=str(result))
    print('CAD: native ' + stage, flush=True)
    subprocess.run([freecad, str(directory / 'Run.FCMacro')], env=env, check=True)
    # FreeCAD can return zero after a macro exception. Require explicit success.
    try:
        record = json.loads(result.read_text())
    except (OSError, ValueError) as exc:
        raise CadError('Native ' + stage + ' did not finish; inspect FreeCAD output') from exc
    if record.get('stage') != stage or not record.get('freecad_version'):
        raise CadError('Invalid native completion record for ' + stage)
    return record['freecad_version']


def publish(root, staged, original, tools):
    exports = validate_inventory(staged)
    manifest = {
        'format_version': 1,
        'tools': tools,
        'inputs': hashes(staged, INPUTS),
        'exports': hashes(staged, exports),
    }
    try:
        previous_meshes = {p for p in required_exports(Snapshot(root)) if PurePosixPath(p).suffix in {'.stl','.3mf'}}
    except CadError:
        # Missing/damaged generated output must not prevent a rebuild. Without
        # its inventory, do not delete old meshes; the final check rejects orphans.
        previous_meshes = set()
    ensure_unchanged(root, original)
    import native_publication
    files = {path: staged.read(path) for path in exports | {MASTER, 'design-v2.md'}}
    files[MANIFEST] = (json.dumps(manifest, indent=2, sort_keys=True) + '\n').encode()
    native_publication.publish(root, root / '.build/wide-publication', files,
                               (previous_meshes | RETIRED_EXPORTS) - exports, MANIFEST,
                               lambda: check_freshness(Snapshot(root), publishing=True))


def rebuild(root):
    freecad = shutil.which('freecad') or '/Applications/FreeCAD.app/Contents/Resources/bin/freecad'
    ffmpeg, ffprobe = shutil.which('ffmpeg'), shutil.which('ffprobe')
    godot = shutil.which('godot')
    if not Path(freecad).is_file() or not (ffmpeg and ffprobe and godot):
        raise CadError('Install the build tools: brew install just ffmpeg; brew install --cask freecad godot')
    (root / ".build").mkdir(exist_ok=True)
    with build_lock(root), tempfile.TemporaryDirectory(prefix='smart-compass-cad-', dir=root / ".build") as temporary:
        import native_publication
        native_publication.recover(root, root / '.build/wide-publication')
        source = Snapshot(root)
        staged = Snapshot(Path(temporary))
        original = {}
        for path in INPUTS:
            data = source.read(path)
            original[path] = digest(data)
            target = staged.root / path
            target.parent.mkdir(parents=True, exist_ok=True)
            target.write_bytes(data)
        directory = staged.root / CAD
        subprocess.run([sys.executable, '-m', 'unittest', 'discover', '-s', str(directory),
                        '-p', 'test_*.py', '-v'], cwd=staged.root, check=True)
        version = native_stage(freecad, directory, 'build')
        import inventory
        inventory.export(staged.root)
        native_stage(freecad, directory, 'check')
        import slicing
        slicing.generate(staged.root)
        slicer_version = slicing.check(staged.root, fresh=False)
        native_stage(freecad, directory, 'demo')
        print('CAD: validate and capture interactive lighting comparisons', flush=True)
        subprocess.run([sys.executable, str(staged.root / 'demo/run.py'), 'capture'], check=True)
        tools = {'freecad': version, 'prusaslicer': slicer_version}
        tools['godot'] = subprocess.check_output([godot, '--version'], text=True).strip()
        for name, executable in (('ffmpeg', ffmpeg), ('ffprobe', ffprobe)):
            tools[name] = subprocess.check_output([executable, '-version'], text=True).splitlines()[0]
        import service_package
        service_package.generate(staged.root)
        publish(root, staged, original, tools)
        mass = load_json(Snapshot(root), EXPORTS + '/parts.json')['mass_estimate']
        print('CAD BUILD COMPLETE: model and all exports checked; freshness manifest written.', flush=True)
        print(f"Complete pendant: {mass['complete_pendant']['nominal_g']} g; "
              f"necklace: {mass['necklace']['nominal_g']} g; "
              f"total worn: {mass['total_worn']['nominal_g']} g. Physical mass unmeasured.", flush=True)



def main():
    parser = argparse.ArgumentParser(description=__doc__)
    parser.add_argument('command', choices=('build', 'check'))
    parser.add_argument('--staged', action='store_true', help='Check the Git index, not working files')
    args = parser.parse_args()
    if args.staged and args.command != 'check':
        parser.error('--staged only applies to check')
    try:
        # Narrow is the selected prototype. Preserve the old wide archive
        # functions for archive integrity and their regression evidence.
        command=[sys.executable,str(ROOT/'designs/stacked/run.py'),args.command]
        if args.staged:command.append('--staged')
        subprocess.run(command,cwd=ROOT,check=True)
    except (CadError, OSError, subprocess.CalledProcessError) as exc:
        print('CAD ERROR: ' + str(exc), file=sys.stderr)
        print('Save and close the model, then run `just cad`.', file=sys.stderr)
        if args.staged:
            print('Stage the model, build sources, exports and manifest together.', file=sys.stderr)
        return 1
    return 0


if __name__ == '__main__':
    raise SystemExit(main())
