BlinkyStitt/smart-compass-v0/lights-clock.ino

// TODO: the time library is not working well. its running really 16 seconds behind after only a minute

void updateLightsForClock() {
  // turn the time into a watch face with just an hour hand
  static int adjusted_seconds = 0;
  static int adjusted_minute = 0;
  static int adjusted_hour = 0;

  // we use GPS for time instead of the slower internal rtc
  if (!GPS.fix) {
    updateLightsForLoading();
    return;
  }

  EVERY_N_MILLISECONDS(500) {
    // TODO: do we care about gpsMs? we only have 16 lights of output
    adjusted_seconds = GPS.seconds;

    // TODO: handle fractional timezone
    adjusted_minute = GPS.minute + adjusted_seconds / 60.0;

    // we include the minute_led_ids here in case of fractional timezones. we will likely drop the minute_led_id
    // hours start at 1, not 0!
    adjusted_hour = GPS.hour + time_zone_offset + adjusted_minute / 60.0;
    if (adjusted_hour <= 0) {
      adjusted_hour += 12;
    } else if (adjusted_hour > 12) {
      adjusted_hour -= 12;
    }
  }

  print2digits(adjusted_hour);
  DEBUG_PRINT(":");
  print2digits(adjusted_minute);
  DEBUG_PRINT(":");
  print2digits(adjusted_seconds);
  DEBUG_PRINTLN();

  // TODO: is there a formula for this?
  int hour_led_id = inner_ring_start;
  switch (adjusted_hour) {
  case 1:
    hour_led_id += 8;
    break;
  case 2:
    hour_led_id += 7;
    break;
  case 3:
    hour_led_id += 5;
    break;
  case 4:
    hour_led_id += 4;
    break;
  case 5:
    hour_led_id += 3;
    break;
  case 6:
    hour_led_id += 1;
    break;
  case 7:
    hour_led_id += 0;
    break;
  case 8:
    hour_led_id += 15;
    break;
  case 9:
    hour_led_id += 13;
    break;
  case 10:
    hour_led_id += 12;
    break;
  case 11:
    hour_led_id += 11;
    break;
  case 12:
    hour_led_id += 9;
    break;
  }

  // inner ring and outer ring are wired in opposite directions
  // we also need to rotate 180 degrees since the rings are upside down
  // int inner_minute_led_id = (map(adjusted_minute, 0, 60, inner_ring_size, 0) + inner_ring_size / 2) % inner_ring_size
  // + inner_ring_start;
  int outer_minute_led_id =
      (map(adjusted_minute, 0, 60, 0, outer_ring_size) + outer_ring_size / 2) % outer_ring_size + outer_ring_start;

  // int inner_second_led_id = (map(adjusted_seconds, 0, 60, inner_ring_size, 0) + inner_ring_size / 2) %
  // inner_ring_size + inner_ring_start;
  int outer_second_led_id =
      (map(adjusted_seconds, 0, 60, 0, outer_ring_size) + outer_ring_size / 2) % outer_ring_size + outer_ring_start;

  /*
  DEBUG_PRINT("hour, minute, second: ");
  DEBUG_PRINT(hour_led_id);
  DEBUG_PRINT(" ");
  DEBUG_PRINT(minute_led_id);
  DEBUG_PRINT(" ");
  DEBUG_PRINTLN(second_led_id);
  */

  // TODO: I'm not sure what color the noon marker should be or if we even need one
  // TODO: what colors should the leds be?
  // TODO: i'm not sure i like how i'm handling overlapping
  // TODO: blink instead of full brightness?

  // fade all lights
  fadeToBlackBy(leds, num_LEDs, LED_FADE_RATE);

  // set minute first so second passes over it
  // leds[inner_minute_led_id] = CRGB::Blue;
  leds[outer_minute_led_id] = CRGB::Blue;

  // set second
  // leds[inner_second_led_id] = CRGB::Yellow;
  leds[outer_second_led_id] = CRGB::Yellow;

  // set hour last so it is always on top
  // hour is only on the inner ring
  leds[hour_led_id] = CRGB::Red;
}

void print2digits(int number) {
  if (number < 10) {
    DEBUG_PRINT("0");
  }
  DEBUG_PRINT(number);
}
