BlinkyStitt/smart-compass-v0/debug.h

// TODO: actually use these

#ifdef DEBUG
 #define DEBUG_PRINT(x)      Serial.print(x)
 #define DEBUG_PRINT(x, y)   Serial.print(x, y)
 #define DEBUG_PRINTLN(x)    Serial.println(x)
 #define DEBUG_PRINTLN(x, y) Serial.println(x)
#else
 #define DEBUG_PRINT(x)
 #define DEBUG_PRINT(x, y)
 #define DEBUG_PRINTLN(x)
 #define DEBUG_PRINTLN(x, y)
#endif
