BlinkyStitt/smart-compass-v0/(commit log)

2018-05-21 sort after inserting
2018-05-29 fix pins and magnetic variation
2018-05-30 gps on a timer
2018-06-03 format and split timers into their own file
2018-06-03 set lights with accelerometer
2018-06-04 optional sensor
2018-06-12 fix SD 5v wiring
2018-06-12 cleaner traces
2018-06-12 Revert "cleaner traces"
    This reverts commit e3b564a9b9b9441344b67457b7c4fb00d212bf07.
2018-06-12 Revert "fix SD 5v wiring"
    This reverts commit 9959775cd904eace4dc193857ed3f888d1a05c7f.
2018-06-12 HIGH SPI CS for allthethings
2018-06-12 a design with no overlapping traces
2018-06-14 debug prints and better config parsing
2018-06-14 improve debug prints
2018-06-14 enum for battery
2018-06-14 more debug prints and orientation changes
2018-06-28 improve framerate. debug print to figure out crash
2018-07-04 use internal rtc instead of timers
2018-07-04 better framerate and fix gps precision
2018-07-06 debug at full power
2018-07-07 slow it down more. more power
2018-07-09 faster pin saving
2018-07-10 save some power
2018-07-10 i was wrong about charging
2018-08-20 change orientation in case
2018-08-24 sigh. i just needed to lower the light's power
2018-08-24 read the sensor less and never during radio/gps processing
2026-10-09 docs: design two-board smart compass project
2026-10-10 docs: specify shared patterns battery dimming and LED calibration
2026-10-11 docs: expand smart compass contracts and track design gaps
2026-10-11 docs: define circle and two 120 LED per meter rings
2026-10-11 docs: specify BlackPill battery voltage sensing
2026-10-11 docs: plan round necklace enclosure and ring geometry
2026-10-11 feat: revise compass enclosure for radial rings and infinity mirror
2026-10-12 Model ribbed PETG rear, sourced battery pockets and repairable necklace mounts
2026-10-12 Fit protected LiPo and external battery entry with curved ring diffusers
2026-10-12 Add rotating and exploded CAD demo animations
2026-10-12 Use one laser-cut wood grid for the Fibonacci face and cell dividers
2026-10-12 Add checked CAD rebuild command and staged export freshness guard
2026-10-12 Add Godot lighting and single-sheet assembly previews
2026-10-12 Slow Godot camera sweeps while preserving LED timing
2026-10-12 Use smooth shared diffusion for all LED rings
2026-10-12 Replace pulsing previews with moving LED gradients
2026-10-12 Simplify enclosure printing and rear service with one front sheet
2026-10-12 Add print-fit samples and assembly lead-ins for whole circular parts
2026-10-13 Strengthen whole-circle prints and add replaceable service fasteners
2026-10-13 Restore exploded assembly animation with a seamless Godot loop
2026-10-13 Unify fabrication projects, joint fit, and complete build accounting
    Generate delivered PrusaSlicer projects from one PETG specification and slice
    those exact projects without private setting overrides. Check embedded and
    effective toolpath settings, and include every project in freshness validation.
    Use selected plain-nut dimensions and one allowance rule for captive pockets.
    Model the screw/nut/washer envelopes, clear the suspension from vent hardware,
    round load transitions and webbing lips, and add actual-joint fit samples.
    Retain whole circles, the continuous rear skin and the selected clear-centre
    front. Relieve board feet internally and round rear rib and clamp roots.
    Generate the c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
2026-10-13 Design whole glow PETG rings and service-fit enclosure
2026-10-13 Shield exposed LED edges above glow rings
2026-10-14 Separate the stencil from the populated LED board in exploded views
2026-10-14 Use production deck layers for the optical fit sample
2026-10-14 Constrain printed rings and clear the LED edge shields
2026-10-14 Finish body bolts to the measured clamp stack
2026-10-14 Thicken the outside glow ring to 2 mm
2026-10-14 Use directory locks for CAD builds
2026-10-14 Add a sample-first print service handoff package
2026-10-15 Specify opaque black PETG for structural print parts
2026-10-15 Restore wide camera sweeps and consistent worn renders
2026-10-15 Store CAD and preview assets with Git LFS
2026-10-15 Use original EGL stencil and black acrylic for night previews
    Build the original 2 mm stencil from the supplied STL and retain its
    attribution. Use 3 mm nominal black LED acrylic and derive clamp heights
    from measured stock. Keep the fixed mirror reflecting planes.
    Clip preview light to the original apertures, include black-sheet optical
    loss, and move camp lights behind the wearer. Preserve the wide glow and
    silver sweeps, separate exploded layers, and transparent separated mirrors.
    Centre all service projects and check complete extrusion bounds. Refresh
    the CAD, 17-part/14-sample packages, media and freshness manifest.
    Validation: 50 host tests, native CAD, 37 centred slicer projects, G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
2026-10-15 Clarify reflected LED rows in the infinity preview
    Reduce the shared axial scatter scale to show separate reflected light bands
    at the fixed 11.2 mm mirror gap. Keep mirror coefficients, glow decay and
    camera movement unchanged, and label the diffusion as unmeasured.
    Add GPU checks for smooth axial falloff and reflection contrast. Regenerate
    the canonical CAD, service packages and all preview media through the full
    build. All 31 physical STL meshes and 37 3MF payloads remain unchanged.
    Validation: 50 CAD host tests, native CAD checks, 37 slicer projects, 4 demo
    host tests, scene checks, GPU diffuser/glow/silver/centre checks, 105 mirror
    ray cases, full media decoding, encoded rainbow frame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
2026-10-16 Widen outside light band to three LED strips
2026-10-16 Thin the wide enclosure and expose its mirror gap
2026-10-16 Lower the stacked enclosure and use two side strips
2026-10-16 Share rainbow animation and verify recorded LED motion
2026-10-16 Upload narrow LED colours before every captured frame
2026-10-16 Enlarge the stacked mirror design to 200 mm
2026-10-16 Show total worn weight and record field-swappable battery choice
2026-10-17 Restore the full animated exploded assembly on the site
2026-10-17 Fix unattended native CAD exit and refresh validated assets
2026-10-18 Publish dark-region rainbow comparisons for both enclosures
2026-10-19 feat(cad): constrain internal wire antenna placement and service clearance
2026-10-19 feat(cad): add serviceable compact antenna route and matched exports
2026-10-19 test(cad): validate and regenerate exports after master rebase
2026-10-19 fix(site): account for compact antenna in mass estimates
2026-10-31 docs: record SKI-1230 battery qualification gate and single-cell requirements
2026-10-31 Model retained-rail supervisor interlock for boost shutdown
2026-10-31 Model coupled rail discharge and separate reset from startup lockout
2026-10-31 Specify two-conductor harnesses and audit shared rail currents
2026-10-31 Model conditional thermal envelopes across battery circuit states
2026-10-31 Add independent physical OFF clamp to boost interlock candidate
2026-10-31 Bind Sparkle power ports and propagate cascaded supply demand
2026-10-31 Model KILL filter dynamics and cutoff ordering under supply ramps
2026-10-31 Bound fuse terminal stress and cold-operation thermal limits
2026-11-03 build(cad): refresh native exports and provenance
2026-11-03 feat(power): adopt protected XTAR cell reference
2026-11-04 feat(power): source the rainbow demand estimate
2026-11-05 fix(power): separate prototype review from physical qualification
2026-11-05 feat(power): select strip stock and wire peripheral supplies
2026-11-05 feat(power): select a protected cell with a published mass bound
2026-11-05 fix(power): drain isolated rails and size the Fibonacci fuse for PWM
2026-11-05 feat(enclosure): model captive removable-cell access and check continuous motion
2026-11-05 fix(power): share the prototype load scenario and account for module losses
2026-11-05 fix(power): distinguish OFF contact isolation from reset timing
2026-11-05 fix(enclosure): fit the rear interface and insulate the keeper slot
2026-11-05 refactor(power): use leaded protection and passives for module assembly
2026-11-05 fix(power): specify direct START actuator and signal wire stock
2026-11-05 fix(power): use opposite START contact groups
2026-11-05 fix(power): retain unrounded wire resistance limits
2026-11-05 feat(enclosure): check installed obstacles with exact distance pruning
2026-11-05 feat(enclosure): add separate guarded rear control mounts
2026-11-05 fix(power): retain Mode Action inputs and ADC filter
2026-11-05 fix(power): exclude BlackPill flash from battery sense pins
2026-11-05 feat(enclosure): mount retained Mode and Action controls
2026-11-05 feat(enclosure): fit fixed cell leads and main fuse reservation
2026-11-05 fix(power): bind classic IMU wiring to revision A pads
2026-11-05 fix(power): retain factory Sparkle LED terminals
2026-11-05 fix(hardware): use wire-mount cell contacts and fitted insulators
2026-11-05 fix(power): use sourced PowerBoost screw terminals
2026-11-05 fix(hardware): mount the source latch PCB with rated wire clamps
2026-11-05 fix(hardware): support the IMU at its source mounting holes
2026-11-05 fix(hardware): mount the PowerBoost PCB and screw terminals
2026-11-05 fix(hardware): clear the battery ribbon anchor at the latch carrier
2026-11-05 fix(hardware): support the bulk capacitor and keep its valve clear
2026-11-05 fix(hardware): clear captive nut insertion and drop paths
2026-11-05 fix(hardware): fit the compact capacitor holder between its neighbors
2026-11-05 fix(power): bind GPS and radio leads to the source PCB pads
2026-11-05 Add source-hole GPS mounting fixture and checks
2026-11-05 Retain Wide GPS orientation for nut insertion clearance
2026-11-05 Select fixed Sparkle input and source-hole mounting fixture
2026-11-05 Clear Sparkle nut access and bound underside pins from source
2026-11-05 Bind BlackPill wires to original V3.1 header coordinates
2026-11-05 Fit the source radio board and removable antenna carrier
2026-11-05 Refresh the selected fuse datasheet revision
2026-11-05 Fit the battery sense loom to the BlackPill carrier
2026-11-05 Support all five selected axial branch fuses on a removable carrier
2026-11-05 Clear installed controls and preserve full fuse nut access
2026-11-05 Add clearance margin below the branch fuse ties
2026-11-05 Fit the six discharge resistors above the BlackPill loom
2026-11-05 Align battery service guidance with the module prototype
2026-11-06 Document separate built-prototype qualification procedures
2026-11-06 Restrain the main fuse joints clear of both enclosures
2026-11-07 Complete narrow removable-cell prototype and fitted loom
    Complete all 92 source-bound wire routes and the full 600-product narrow
    assembly, captive cell access, source-based fixtures and service checks.
    Deliver coherent CAD/print/media/inventory/runtime/Pages artifacts and
    correct selected assembly instructions. Preserve the wide archive,
    approved patterns/glare repair and unmeasured physical proof boundaries.
2026-11-09 Show the narrow design with fullscreen media and animated assembly
2026-11-09 Make narrow case perimeter smooth and flush
2026-11-10 Make website copy and battery estimates clear
2026-11-10 Restore Safari autoplay and spread the exploded assembly
2026-11-10 Animate Pride along the Fibonacci LED wiring
2026-11-11 Simplify the narrow enclosure and battery assembly
2026-11-11 Prototype the narrow plug-in electronics carrier
2026-11-11 Reserve service slack for carrier wiring
2026-11-12 Route the narrow carrier and design USB-C wall power
2026-11-12 Prepare the Rev A carrier for fit printing
2026-11-12 Complete the Rev A mechanical print set
2026-11-13 Reduce the Rev A enclosure to twelve printed parts
2026-11-13 Route USB-C wall power and battery charger boards
2026-11-13 Specify available pigtail bypass and split fabrication drills
2026-11-13 Fit connection schematics within the drawing sheet
2026-11-13 Open the charger temperature loop when the cell is removed
2026-11-13 Add 60 W USB-C PD wall power and brighter display mode
2026-11-13 Allow head wiring clearance and document Sparkle file upload
2026-11-13 Keep eFuse timing and status components within rated voltage
2026-11-13 Integrate USB-C power into the compass rear cover
2026-11-13 Latch off the shared LED supply on sustained faults
2026-11-13 Key the positive battery contact in the existing clamp
2026-11-14 Locate the versioned slicer bundle on the mounted release image
2026-11-14 Use the actual PrusaSlicer bundle inside Original Prusa Drivers
2026-11-14 Use a 1.5 mm rear mirror in the narrow compass
